antoniopuma23-blip/inspeccion-tableros/requirements-sim.txt

# Dependencias para ejecutar en una laptop en modo simulación (ROBOT_SIM=1)
# y para correr las pruebas. No requiere ningún hardware.
flask>=3.0,<4
flask-socketio>=5.3,<6
simple-websocket>=1.0
numpy>=1.24
opencv-python-headless>=4.8
reportlab>=4.0
pyyaml>=6.0
psutil>=5.9
smbus2>=0.4
pytest>=7.4
