antoniopuma23-blip/inspeccion-tableros/(commit log)

2026-10-25 Software completo del robot de inspección térmica de tableros eléctricos
    - Drivers con interfaz común real/simulada: motores L298N (PWM por hardware
    con pigpio), encoders de cuadratura, MLX90640, Pi Camera/webcam USB,
    ESP32-S3 opcional por UART (desactivado por defecto).
    - Lógica: watchdog de 500 ms, control skid steering con rampa, límite de
    0.3 m/s y PI con encoders; análisis térmico con ΔT ANSI/NETA MTS y
    corrección de emisividad.
    - Servidor Flask + Flask-SocketIO (threading): video MJPEG, térmico a 4 Hz,
    API REST, SQLite y reporte PDF (ReportLab) con NOM-029-STPS y NFPA 70B.
    - Interfaz web oscura y responsiva: en vivo, captura, historial con
    tendencia, reporte y co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
2026-10-25 Sensores de TechRoach, webcam USB y control Xbox
    - Sensores ambientales reutilizados del proyecto TechRoach en la Raspberry
    Pi: DHT22 (pigpio), MQ-2, MQ-7, LDR y batería con un ADS1115 por I2C,
    PIR y piezoeléctrico por GPIO, zumbador, LED de alarma e iluminación.
    Respaldo con las salidas DO de los MQ si no hay ADS1115.
    - Respuestas automáticas de TechRoach: humedad alta reduce la velocidad,
    alarma de gas detiene el robot y solo permite retroceder, presencia (PIR)
    reduce la velocidad, impacto detiene y la poca luz enciende la
    iluminación. Contra falsas alarmas: calentamiento, mediana, confirmación
    e histéresis. Calibración de R0 en aire limpio.
    - Página Ambiente con lec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
